Llamero/Dual_encoder_controller/Code/GUI_code/Dual encoder controller.png

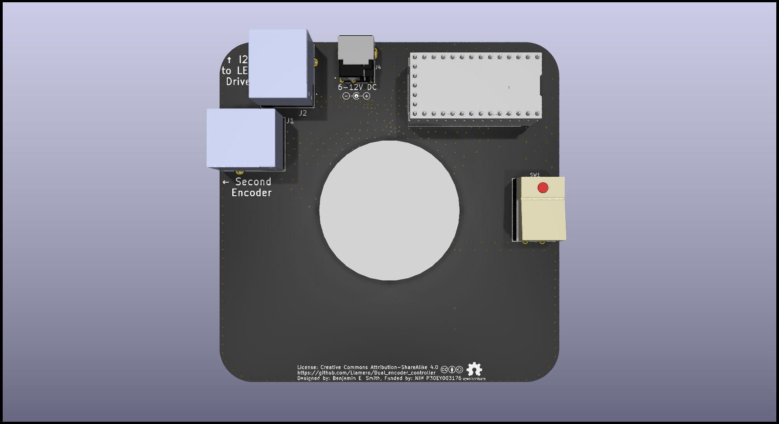
Code/GUI_code/Dual encoder controller.png
