Llamero/Dual_encoder_controller/KiCAD/CAD/EM14RXD-R20-L.stp

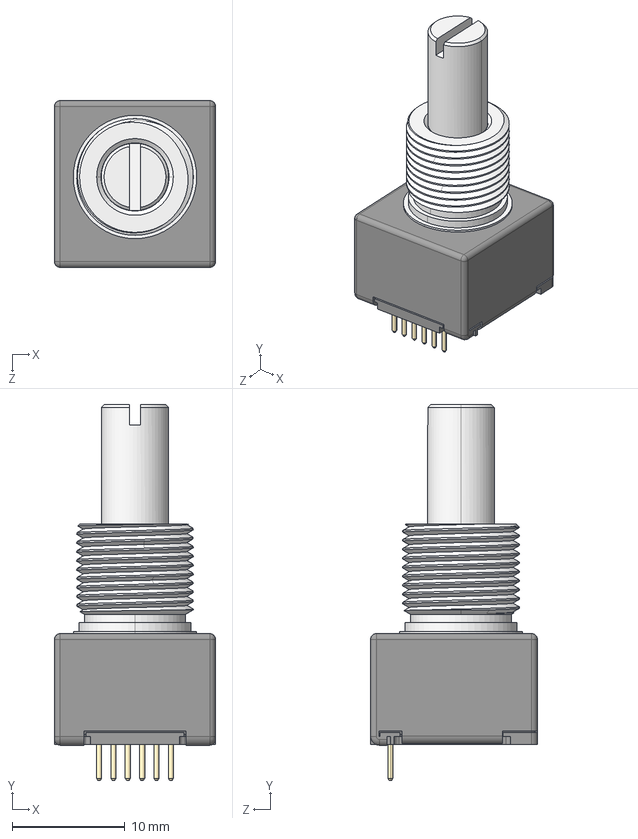
[picture p2: CAD file, 2024-08-20]
KiCAD/CAD/EM14RXD-R20-L.stp
14.2 x 33.3 x 14.8 mm
