Llamero/Dual_encoder_controller/KiCAD/CAD/A-2004-2-4-LPS-N-R.step

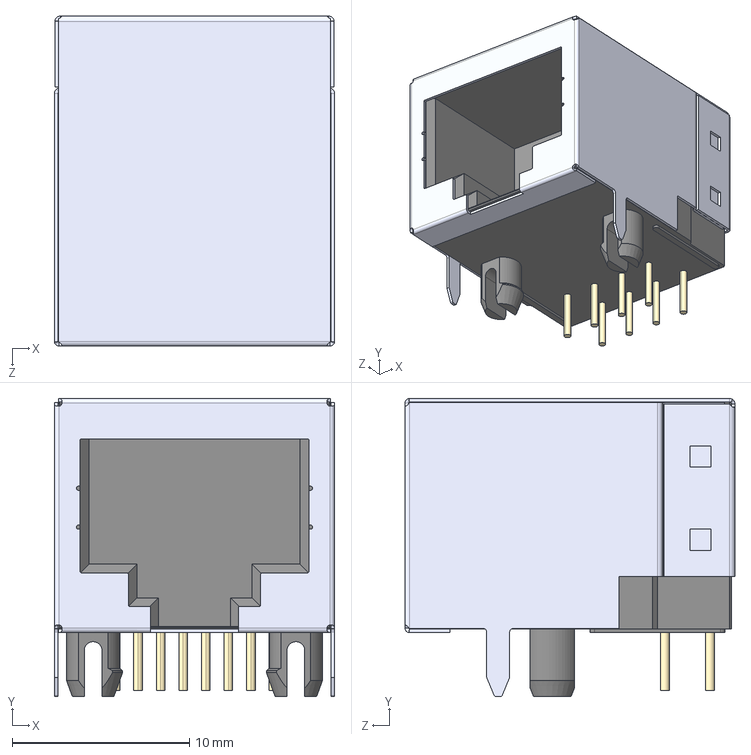
[picture p3: CAD file, 2024-08-20]
KiCAD/CAD/A-2004-2-4-LPS-N-R.step
15.8 x 16.8 x 18.6 mm
