Llamero/Dual_encoder_controller/KiCAD/CAD/b3j-3300.stp

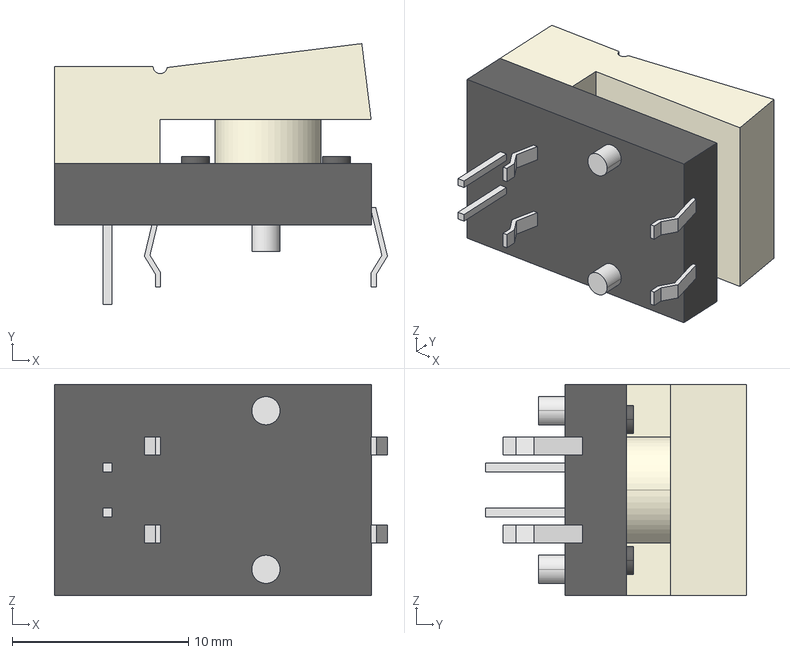
[picture p4: CAD file, 2024-08-20]
KiCAD/CAD/b3j-3300.stp
18.9 x 14.8 x 12.0 mm
