Llamero/Dual_encoder_controller/KiCAD/CAD/4604x.stp

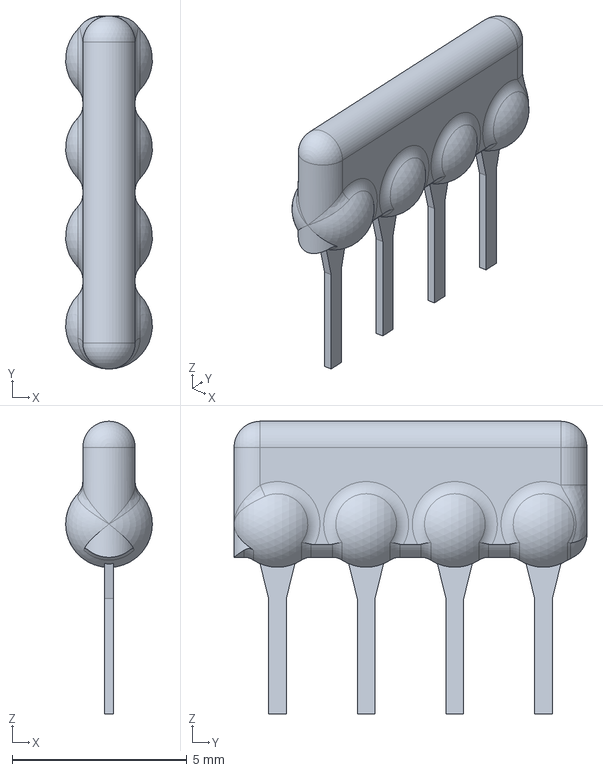
[picture p5: CAD file, 2024-08-20]
KiCAD/CAD/4604x.stp
2.48 x 10.1 x 8.38 mm
