Llamero/Dual_encoder_controller/KiCAD/CAD/54-00128.step

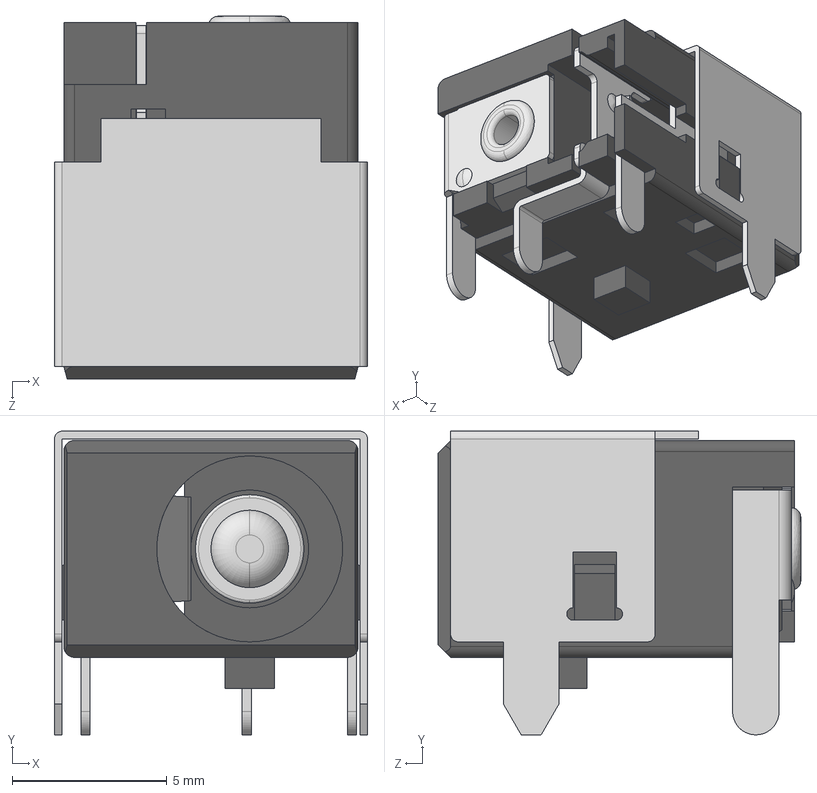
[picture p6: CAD file, 2024-08-20]
KiCAD/CAD/54-00128.step
10.1 x 9.80 x 11.7 mm
