Llamero/Dual_encoder_controller/(list of files, cad)

Other CAD files:
Code/GUI_code/gui_state.obj
