Llamero/Dual_encoder_controller/KiCAD/Dual encoder controller - left.kicad_pcb

## KiCad design KiCAD/Dual encoder controller - left.kicad_pcb (2024-08-23)

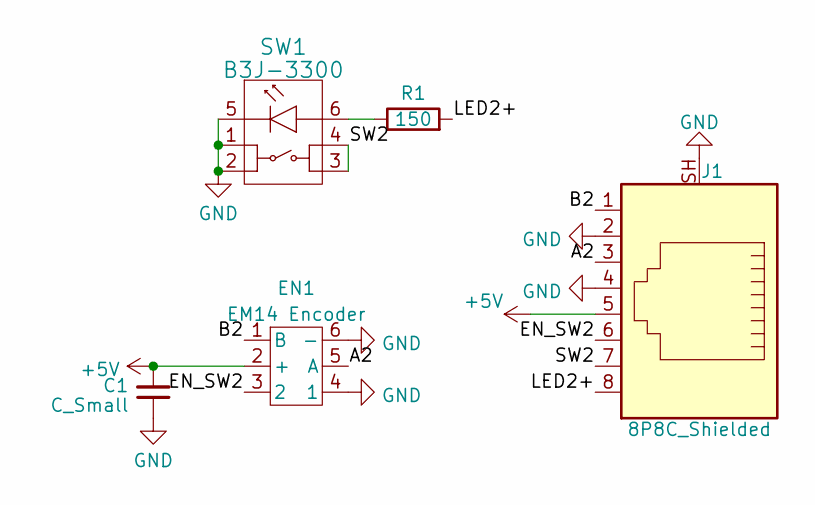
[picture p7: schematic Dual encoder controller - left.kicad_sch]

Parts:
C1: C_Small; C_Rect_L4.0mm_W2.5mm_P2.50mm; Part RCER71H105K2DBH03A
EN1: EM14 Encoder; EM14R0B-M25-L064S; Part EM14R0B-M25-L064S
J1: 8P8C_Shielded; ASSMANN_A-2004-2-4-LPS-N-R; Part A-2004-2-4-LPS-N-R
R1: 150; R_Axial_DIN0207_L6.3mm_D2.5mm_P7.62mm_Horizontal; Part LR1F150R
SW1: B3J-3300; Part B3J-3300

Connections:
+5V: C1.2, EN1.2 (+), J1.5
/A2: EN1.5 (A), J1.3
/B2: EN1.1 (B), J1.1
/EN_SW2: EN1.3 (2), J1.6
/LED2+: J1.8, R1.2
/SW2: J1.7, SW1.3, SW1.4
GND: C1.1, EN1.4 (1), EN1.6 (-), J1.2, J1.4, J1.SH, SW1.1, SW1.2, SW1.5
unnamed: R1.1, SW1.6

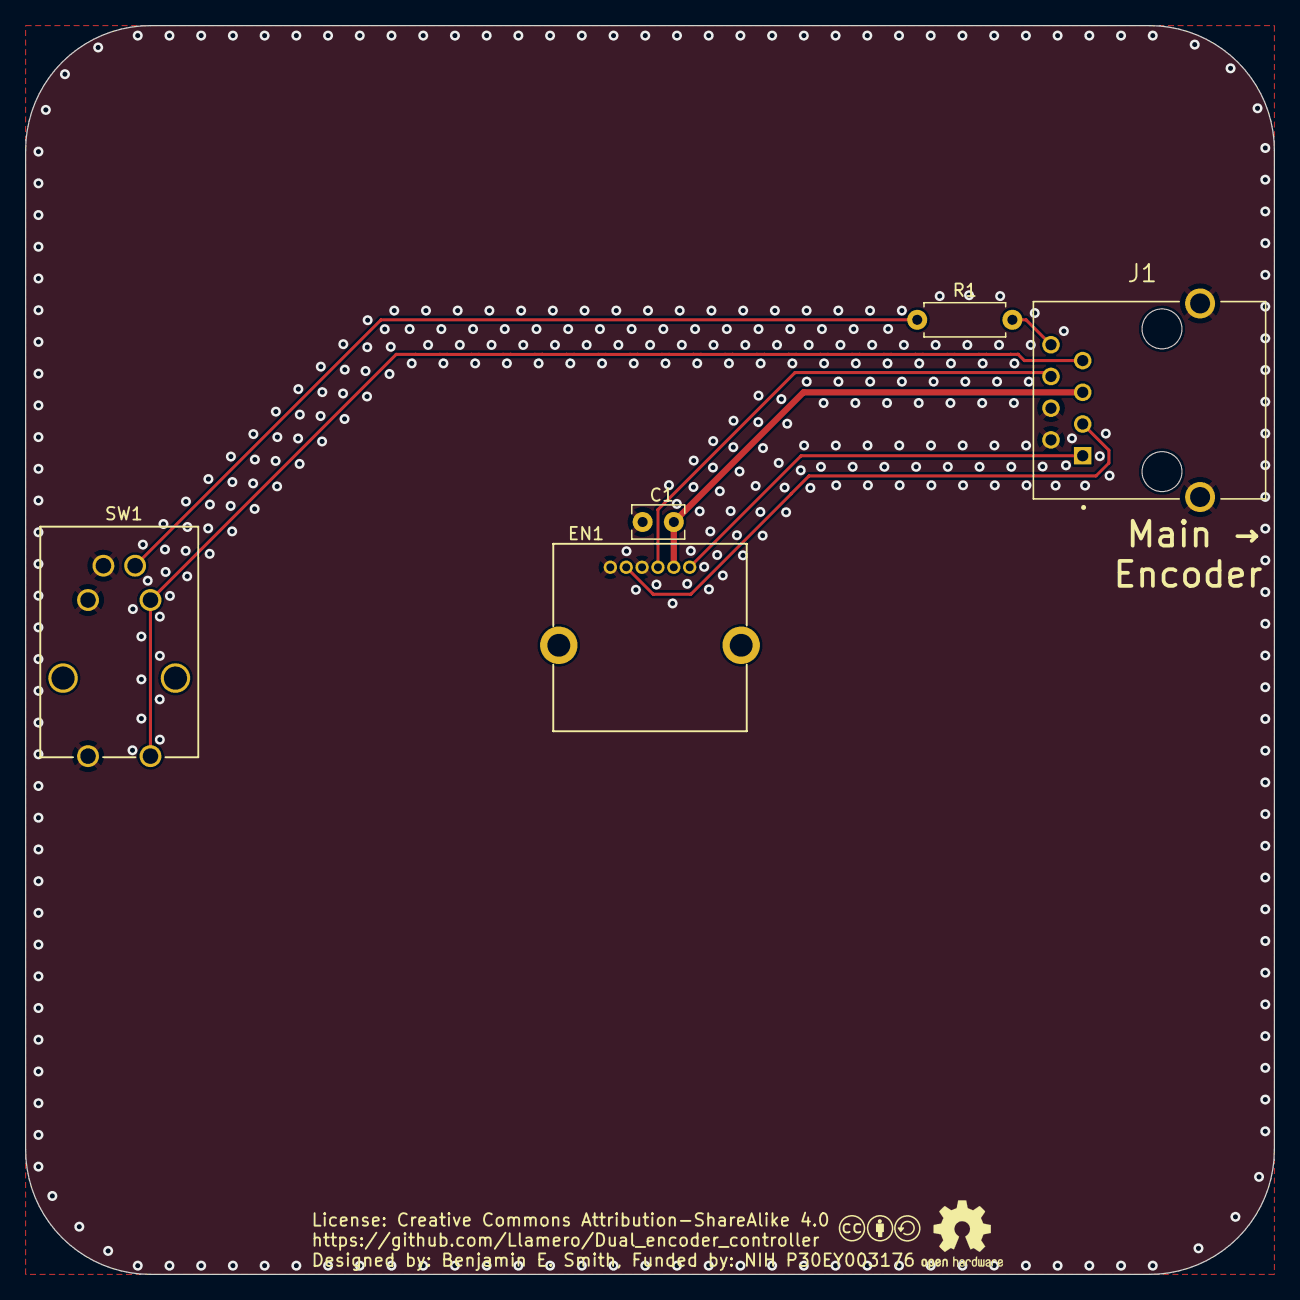
[picture p8: board Dual encoder controller - left.kicad_pcb from above]

Board: 2 copper layers, 100.0 x 100.0 mm, 7 parts (0 on the bottom side), 8 nets.

Other parts of the board:
LOGO1: CC license; Creative_commons_license
LOGO3: OSHW Logo; OSHW-Logo2_7.3x6mm_SilkScreen
