Llamero/Dual_encoder_controller/KiCAD/Dual encoder controller.kicad_pcb

## KiCad design KiCAD/Dual encoder controller.kicad_pcb (2024-08-23)

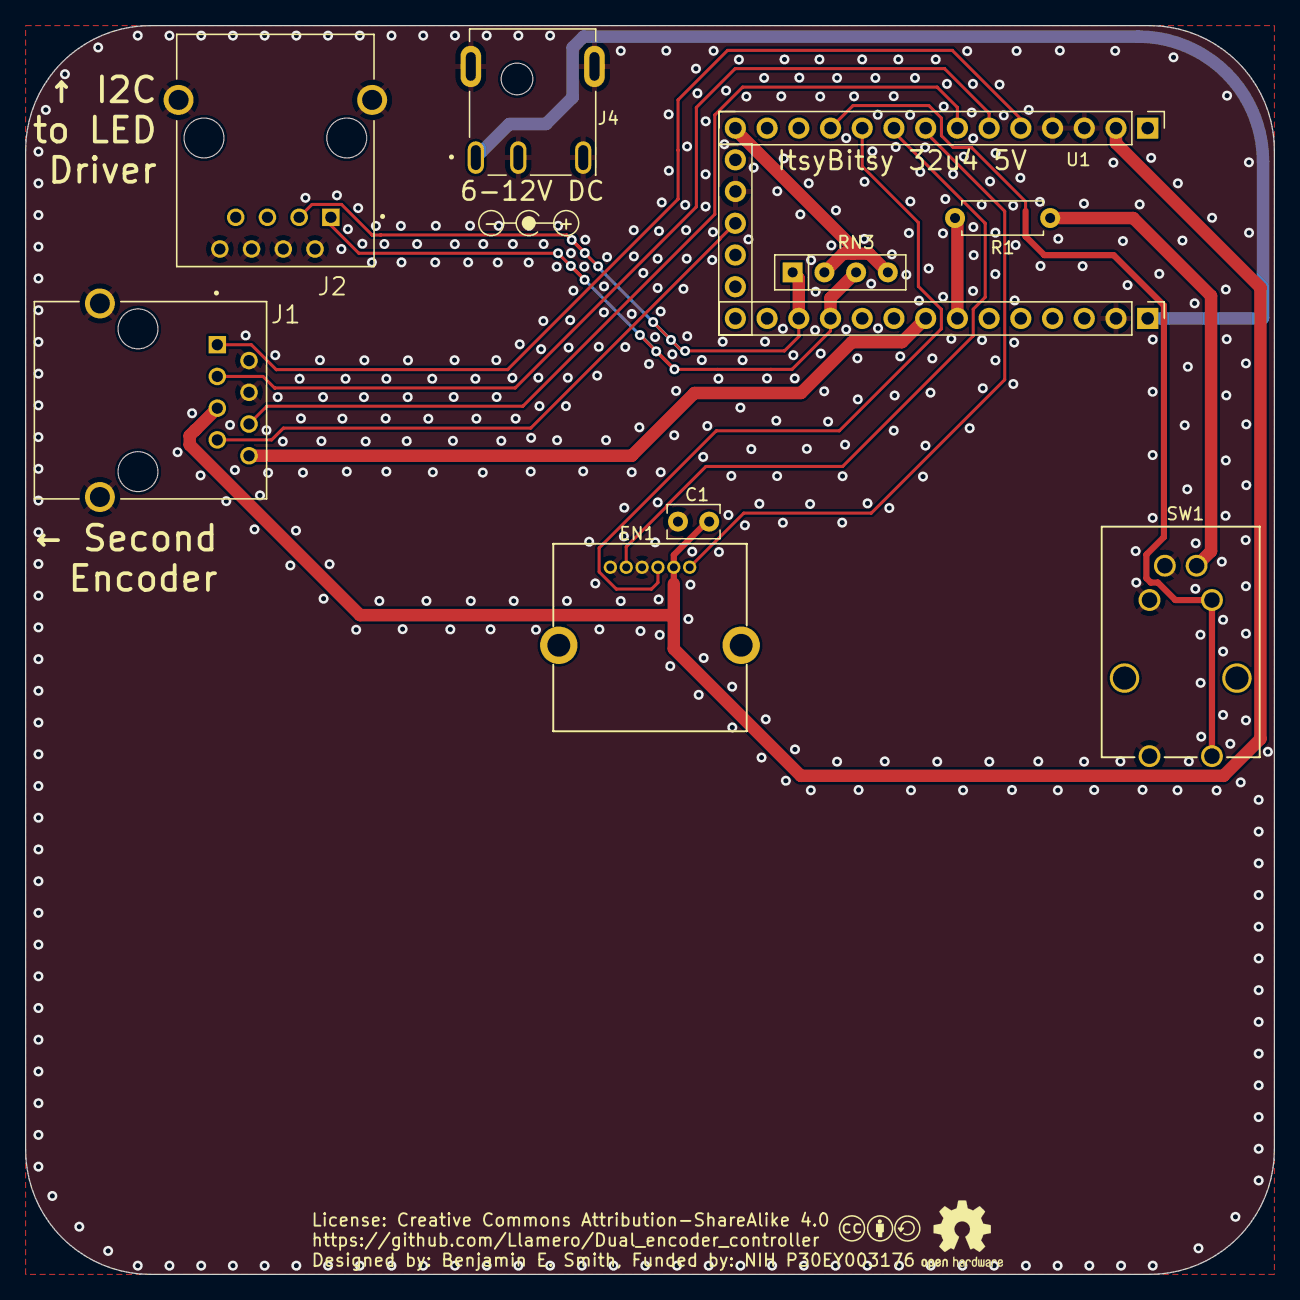
[picture p9: board Dual encoder controller.kicad_pcb from above]

Board: 2 copper layers, 100.0 x 100.0 mm, 12 parts (0 on the bottom side), 17 nets.

Parts:
C1: C_Small; C_Rect_L4.0mm_W2.5mm_P2.50mm
EN1: EM14 Encoder; EM14R0B-M25-L064S
J1, J2: 8P8C_Shielded; ASSMANN_A-2004-2-4-LPS-N-R
J4: 2.5x5.5 Barrel Jack; TENSILITY_54-00128-DC Jack
LOGO1: CC license; Creative_commons_license
LOGO2: Jack Polarity; Polarity_Center_Positive
LOGO3: OSHW Logo; OSHW-Logo2_7.3x6mm_SilkScreen
R1: 150; R_Axial_DIN0207_L6.3mm_D2.5mm_P7.62mm_Horizontal
RN3: 470; R_Array_SIP4
SW1: B3J-3300
U1: Itsy_Bitsy_32u4; Itsy Bitsy 32u4

Connections:
+3.3V: RN3.2 (R1.2), RN3.4 (R2.2), U1.14 (3.3V)
+5V: C1.2, EN1.2 (+), J1.5, U1.2 (5V)
+9V: J4.1, U1.33 (VBat)
/A1: EN1.5 (A), U1.9 (22_A4)
/A2: J1.3, U1.6 (19_A1)
/B1: EN1.1 (B), U1.8 (21_A3)
/B2: J1.1, U1.5 (18_A0)
/EN_SW1: EN1.3 (2), U1.10 (23_A5)
/EN_SW2: J1.6, U1.7 (20_A2)
/LED1+: R1.2, U1.27 (~10_A10)
/LED2+: J1.8, U1.26 (~9_A9)
/SCL: J2.1, RN3.3 (R2.1), U1.23 (~3_SCL)
/SDA: J2.3, RN3.1 (R1.1), U1.22 (2_SDA)
/SW1: SW1.3, SW1.4, U1.11 (15_SCK)
/SW2: J1.7, U1.17 (8_A8)
GND: C1.1, EN1.4 (1), EN1.6 (-), J1.2, J1.4, J1.SH, J2.2, J2.4, J2.6, J2.8, J2.SH, J4.2, J4.3, J4.MP (MountPin), SW1.1, SW1.2, SW1.5, U1.3 (ARef), U1.4 (GND), U1.16 (Gnd), U1.32 (Gnd)
unnamed: R1.1, SW1.6
