Llamero/Dual_encoder_controller/(commit log)

2024-08-20 Initial design upload
    [4604x.stp, 54-00128.step, A-2004-2-4-LPS-N-R.step, Dual encoder controller.kicad_pcb, Dual encoder controller.kicad_sch, EM14RXD-R20-L.stp, b3j-3300.stp]
2024-08-20 Add encoder bypass and guard vias
    [Dual encoder controller.kicad_pcb, Dual encoder controller.kicad_sch]
2024-08-21 Finished working draft
    [Dual encoder controller - left.kicad_pcb, Dual encoder controller - left.kicad_sch, Dual encoder controller.kicad_pcb]
2024-08-21 Both boards pass DRC
    [Dual encoder controller - left.kicad_pcb, Dual encoder controller.kicad_pcb]
2024-08-23 Add gerber
    [Dual encoder controller - left-B_Cu.gbl, Dual encoder controller - left-B_Mask.gbs, Dual encoder controller - left-B_Silkscreen.gbo, Dual encoder controller - left-Edge_Cuts.gm1, Dual encoder controller - left-F_Cu.gtl, Dual encoder controller - left-F_Mask.gts, Dual encoder controller - left-F_Silkscreen.gto, Dual encoder controller - left-NPTH-drl_map.gbr]
2024-10-12 Working code implementation of encoders and buttons
2024-10-22 Add example send and receive I2C code
2025-04-08 GUI can find and connect to controller
    Had to use PySerial as an initial port opener, PyQt5 cannot rx unless another library opens the port first.
    [gui_state.obj]
2025-04-08 Fixed issue with waitForBytesWritten() returning error 12
    https://forum.qt.io/topic/41833/solved-qserialport-waitforbyteswritten-returns-false
    [gui_state.obj]
2025-04-09 Demo with working LEDs!
