Llamero/Dual_encoder_controller/(notices)

Notices in the files:
KiCAD/Dual encoder controller.kicad_pcb:
License: Creative Commons Attribution-ShareAlike 4.0
